wheeler-microfluidics/kicad___teensy-feedback/(commit log)

2016-02-17 Complete layout
    [teensy_feedback-B.Mask.gbs, teensy_feedback-B.Paste.gbp, teensy_feedback-B.SilkS.gbo, teensy_feedback-Back.gbl, teensy_feedback-Edge.Cuts.gm1, teensy_feedback-F.Mask.gts, teensy_feedback-F.Paste.gtp, teensy_feedback-F.SilkS.gto]
2016-02-19 Add back ground plane
    [teensy_feedback-B.Mask.gbs, teensy_feedback-B.Paste.gbp, teensy_feedback-B.SilkS.gbo, teensy_feedback-Back.gbl, teensy_feedback-Edge.Cuts.gm1, teensy_feedback-F.Mask.gts, teensy_feedback-F.Paste.gtp, teensy_feedback-F.SilkS.gto]
2016-04-13 Add component values
    [teensy_feedback-B.Mask.gbs, teensy_feedback-B.Paste.gbp, teensy_feedback-B.SilkS.gbo, teensy_feedback-Back.gbl, teensy_feedback-Edge.Cuts.gm1, teensy_feedback-F.Mask.gts, teensy_feedback-F.Paste.gtp, teensy_feedback-F.SilkS.gto]
2016-04-13 Fix labeling of C1 and C3 (they were swapped)
    [teensy_feedback.kicad_pcb]
2016-04-13 Place decoupling capacitor for op-amp (C8)
    [teensy_feedback-B.Mask.gbs, teensy_feedback-B.Paste.gbp, teensy_feedback-B.SilkS.gbo, teensy_feedback-Back.gbl, teensy_feedback-Edge.Cuts.gm1, teensy_feedback-F.Mask.gts, teensy_feedback-F.Paste.gtp, teensy_feedback-F.SilkS.gto]
2016-07-14 Fix filter topology and add test caps
    [teensy_feedback-B.Mask.gbs, teensy_feedback-B.Paste.gbp, teensy_feedback-B.SilkS.gbo, teensy_feedback-Back.gbl, teensy_feedback-Edge.Cuts.gm1, teensy_feedback-F.Mask.gts, teensy_feedback-F.Paste.gtp, teensy_feedback-F.SilkS.gto]
